Hack-a-Day/Hackaday_Belgrade_Badge_Official/(list of files, drawings)

Other design files:
PCB/HackA.PCB
PCB/HackC.PCB
